urish/ttsky-oscillating-bones/(commit log)

2026-08-27 fix(sim): model analog pad parasitics
    The actual silicon (ttsky25b) produces no output on the digital pins, as the analog parasitics crash the output to ~0.7 V with an ~100 mV amplitude.
    Now we also get similar results in simulation.
    [testbench.sch]
2026-08-27 fix: no output on digital pins
    Analog pin parasitics overwhelm the ua[0] driver, and ua[0] was also the input of the
    1.8 V level shifter that clocks the divider chain. A single skullfet inverter cannot move
    the pad capacitance at 180 MHz, so the net collapsed to a ~100 mV ripple biased at ~0.7 V (measured on ttsky25b),
    below the level shifter's ~0.8 V trip point, causing the digital outputs to never trigger.
    Fix this by adding an extra skullfet that as a buffer for the analog pad output.
    [testbench.sch, tt_um_oscillating_bones.sch]
2026-08-27 refactor(sim): use Sylvain's analog pad model
    [pad_model.sch, testbench.sch]
2026-08-28 fix(sim): generate the DUT instance line instead of hard-coding pin order
